Djeeberjr/fw-anwesenheit/README.md

# fw-anwesenheit

PXL_20251004_141110955 MP (1)

PXL_20251001_103957322 MP~2
