Djeeberjr/fw-anwesenheit/3d_print/enclouseure_printfile.3mf

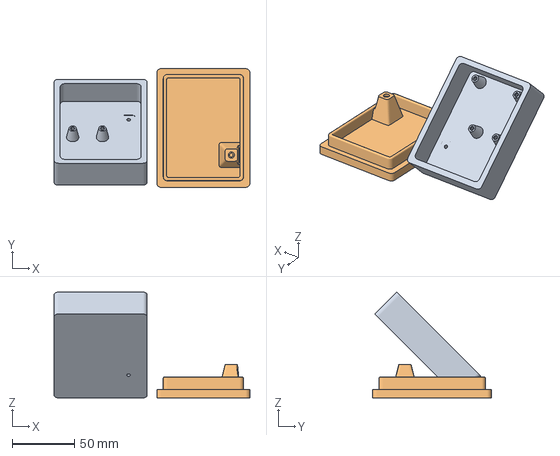
[picture p1: CAD file, 2025-09-21]
3d_print/enclouseure_printfile.3mf
157.7 x 95.5 x 85.2 mm
enclouseure_bot_ffw
enclousure_top_ffw
