Djeeberjr/fw-anwesenheit/3d_print/printfiles/fw-anwesenheit-enclousure-top.3mf

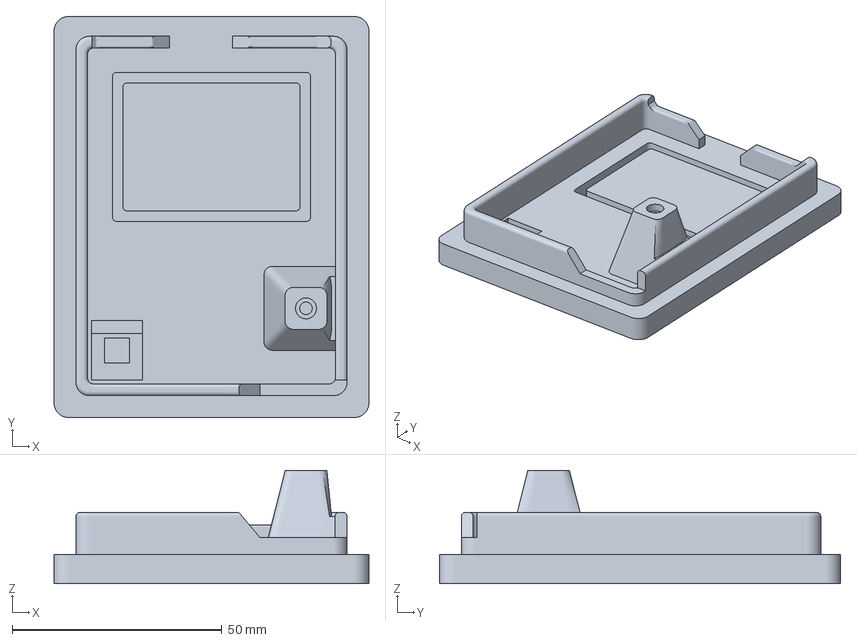
[picture p2: CAD file, 2025-10-01]
3d_print/printfiles/fw-anwesenheit-enclousure-top.3mf
75.0 x 95.5 x 27.0 mm
