Djeeberjr/fw-anwesenheit/3d_print/enclousure_top_ffw.3mf

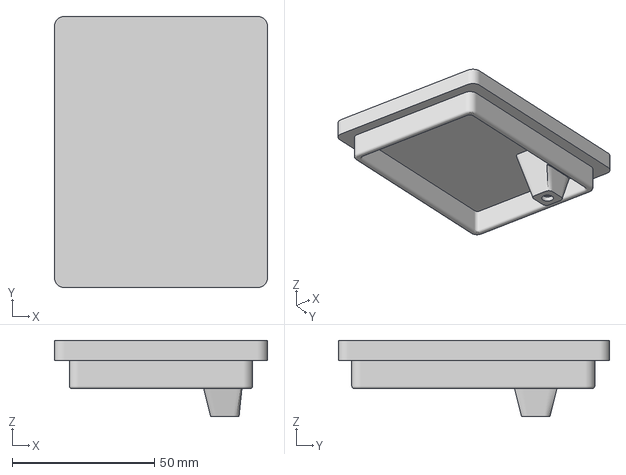
[picture p3: CAD file, 2025-09-21]
3d_print/enclousure_top_ffw.3mf
75.0 x 95.5 x 26.8 mm
