Djeeberjr/fw-anwesenheit/pcb/fw-anwesenheit.kicad_pcb

## KiCad design pcb/fw-anwesenheit.kicad_pcb (2025-09-21)

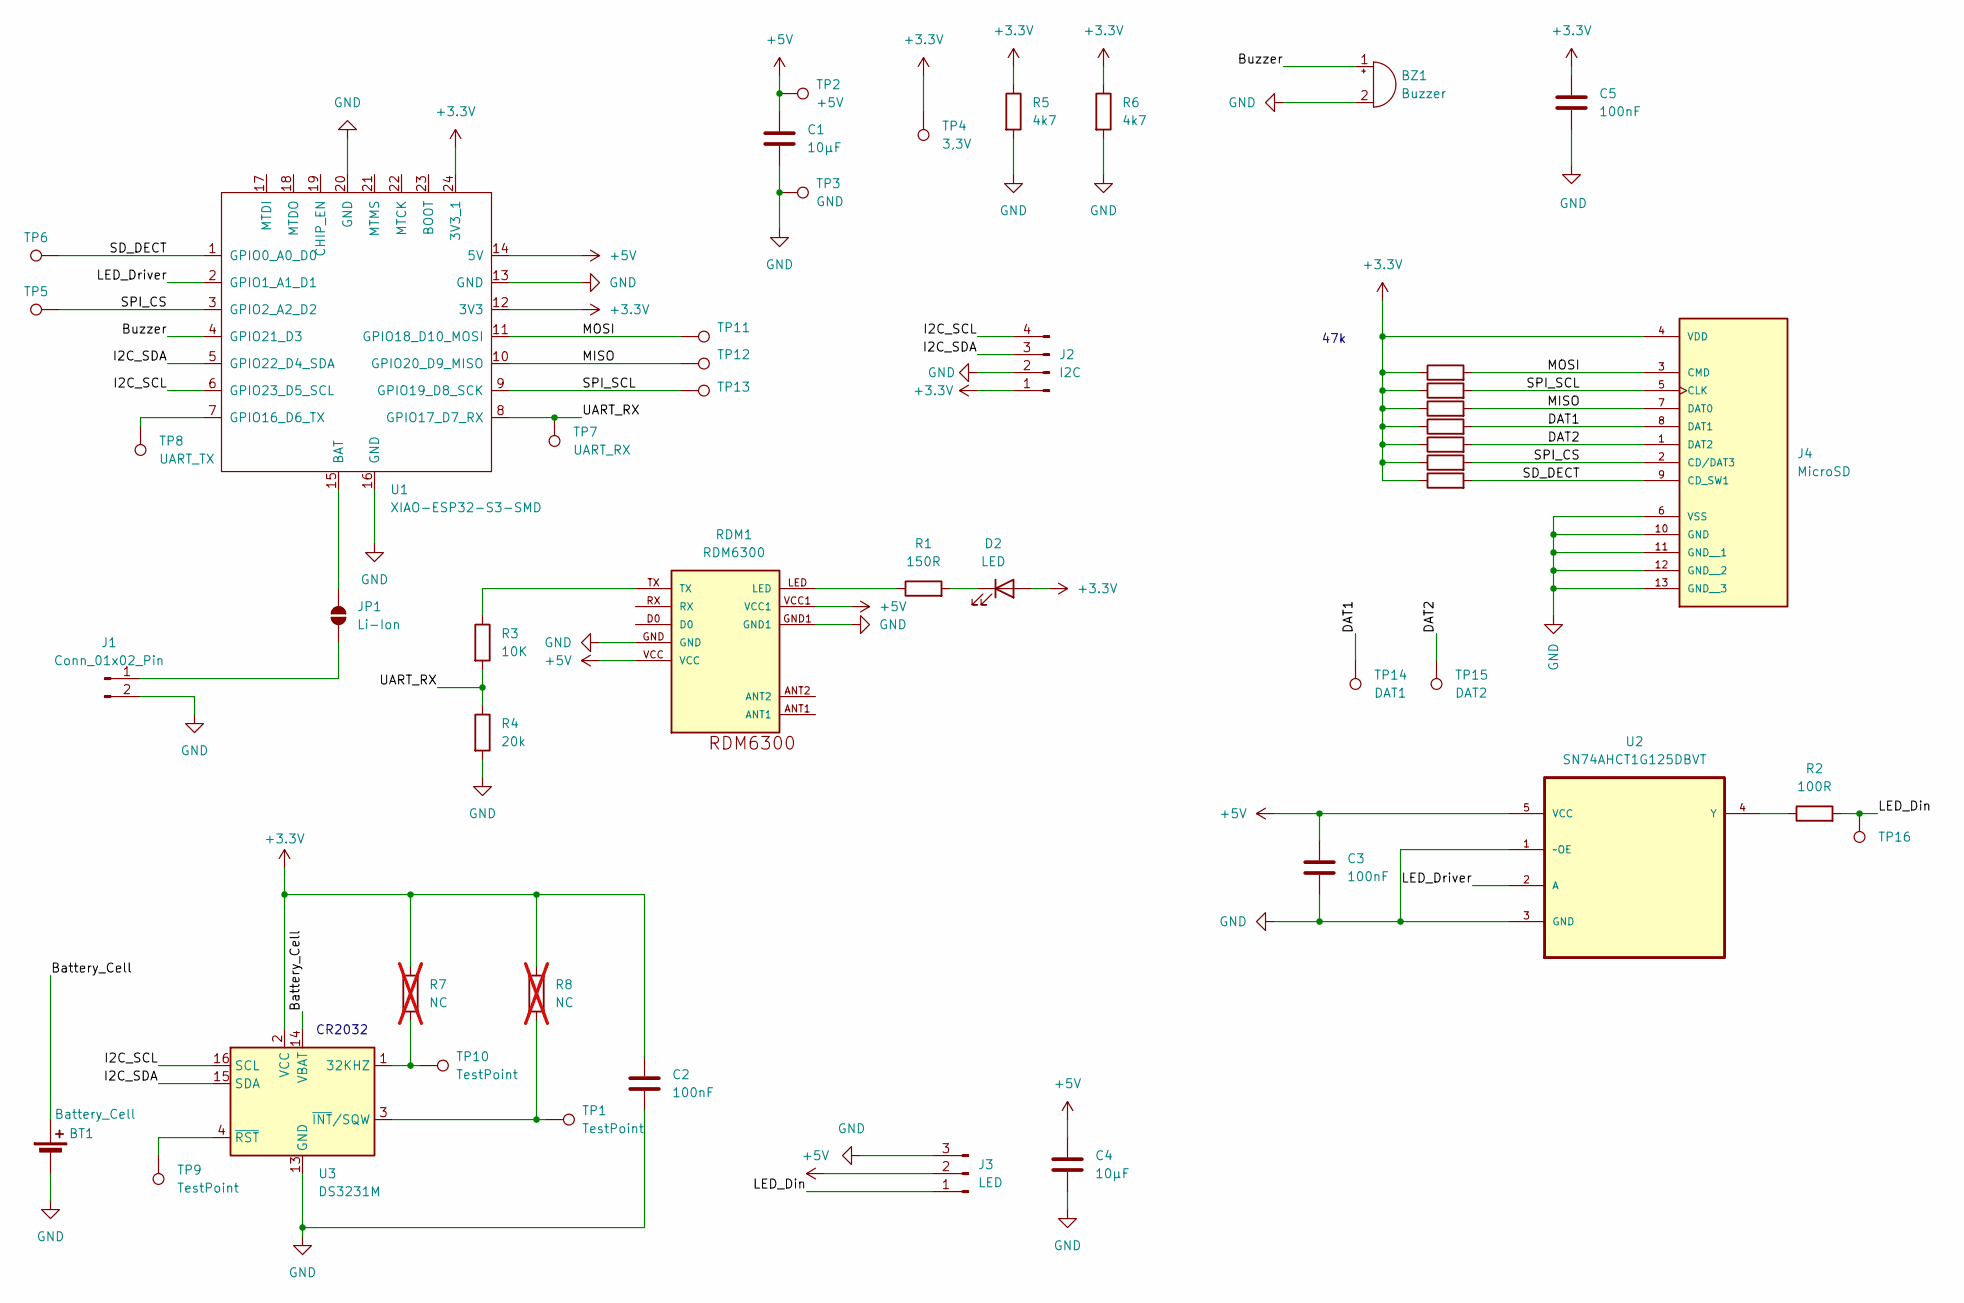
[picture p4: schematic fw-anwesenheit.kicad_sch]

Parts:
BT1: Battery_Cell; Battery_Panasonic_CR2032-HFN_Horizontal_CircularHoles
BZ1: Buzzer; PinSocket_1x02_P2.54mm_Vertical
C1, C4: 10µF; C_0603_1608Metric
C2, C3, C5: 100nF; C_0603_1608Metric
D2: LED; LED_0603_1608Metric
J1: Conn_01x02_Pin; PinHeader_1x02_P2.54mm_Vertical
J2: I2C; PinHeader_1x04_P2.54mm_Vertical
J3: LED; PinSocket_1x03_P2.00mm_Vertical
J4: MicroSD; WURTH_693071020811; PARTREV 001.003
JP1: Li-Ion; SolderJumper-2_P1.3mm_Open_TrianglePad1.0x1.5mm
R1: 150R; R_0603_1608Metric_Pad0.98x0.95mm_HandSolder
R2: 100R; R_0603_1608Metric_Pad0.98x0.95mm_HandSolder
R3: 10K; R_0603_1608Metric_Pad0.98x0.95mm_HandSolder
R4: 20k; R_0603_1608Metric_Pad0.98x0.95mm_HandSolder
R5, R6: 4k7; R_0603_1608Metric_Pad0.98x0.95mm_HandSolder
R7, R8: NC; R_0603_1608Metric_Pad0.98x0.95mm_HandSolder; not fitted
R9, R10, R11, R12, R13, R14, R15: 47k; R_0603_1608Metric_Pad0.98x0.95mm_HandSolder
RDM1: RDM6300
TP1, TP9, TP10: TestPoint; TestPoint_Pad_D1.5mm
TP2: +5V; TestPoint_Pad_D1.5mm
TP3: GND; TestPoint_Pad_D1.5mm
TP4: 3,3V; TestPoint_Pad_D1.5mm
TP5: CS; TestPoint_Pad_D1.5mm
TP6: SD_DECT; TestPoint_Pad_D1.5mm
TP7: UART_RX; TestPoint_Pad_D1.5mm
TP8: UART_TX; TestPoint_Pad_D1.5mm
TP11: MOSI; TestPoint_Pad_D1.5mm
TP12: MISO; TestPoint_Pad_D1.5mm
TP13: SPI SCL; TestPoint_Pad_D1.5mm
TP14: DAT1; TestPoint_Pad_D1.5mm
TP15: DAT2; TestPoint_Pad_D1.5mm
TP16: LED_Din; TestPoint_Pad_D1.5mm
U1: XIAO-ESP32-S3-SMD; XIAO-ESP32C6-SMD
U2: SN74AHCT1G125DBVT; SOT95P280X145-5N; MPN SN74AHCT1G125DBVT
U3: DS3231M; SOIC-16W_7.5x10.3mm_P1.27mm

Connections:
+3.3V: C2.2, C5.2, D2.2 (A), J2.1, J4.4 (VDD), R5.1, R6.1, R7.1, R8.1, R9.1, R10.1, R11.1, R12.1, R13.1, R14.1, R15.1, TP4.1, U1.12 (3V3), U1.24 (3V3_1), U3.2 (VCC)
+5V: C1.2, C3.2, C4.2, J3.2, RDM1.VCC, RDM1.VCC1, TP2.1, U1.14 (5V), U2.5 (VCC)
/Battery_Cell: BT1.1 (+), U3.14 (VBAT)
/Buzzer: BZ1.1 (+), U1.4 (GPIO21_D3)
/DAT1: J4.8 (DAT1), R10.2, TP14.1
/DAT2: J4.1 (DAT2), R15.2, TP15.1
/I2C_SCL: J2.4, U1.6 (GPIO23_D5_SCL), U3.16 (SCL)
/I2C_SDA: J2.3, U1.5 (GPIO22_D4_SDA), U3.15 (SDA)
/LED_Driver: U1.2 (GPIO1_A1_D1), U2.2 (A)
/MISO: J4.7 (DAT0), R12.2, TP12.1, U1.10 (GPIO20_D9_MISO)
/MOSI: J4.3 (CMD), R14.2, TP11.1, U1.11 (GPIO18_D10_MOSI)
/SD_DECT: J4.9 (CD_SW1), R11.2, TP6.1, U1.1 (GPIO0_A0_D0)
/SPI_SCL: J4.5 (CLK), R13.2, TP13.1, U1.9 (GPIO19_D8_SCK)
/UART_RX: R3.2, R4.1, TP7.1, U1.8 (GPIO17_D7_RX)
GND: BT1.2 (-), BZ1.2 (-), C1.1, C2.1, C3.1, C4.1, C5.1, J1.2, J2.2, J3.3, J4.6 (VSS), J4.10 (GND), J4.11 (GND__1), J4.12 (GND__2), J4.13 (GND__3), R4.2, R5.2, R6.2, RDM1.GND, RDM1.GND1, TP3.1, U1.13 (GND), U1.16 (GND), U1.20 (GND), U2.1 (~OE), U2.3 (GND), U3.5 (GND), U3.6 (GND), U3.7 (GND), U3.8 (GND), U3.9 (GND), U3.10 (GND), U3.11 (GND), U3.12 (GND), U3.13 (GND)
unnamed: D2.1 (K), R1.2
unnamed: J1.1, JP1.2 (B)
unnamed: JP1.1 (A), U1.15 (BAT)
unnamed: R1.1, RDM1.LED
unnamed: R3.1, RDM1.TX
unnamed: TP8.1, U1.7 (GPIO16_D6_TX)
unnamed: R2.1, U2.4 (Y)
unnamed: R7.2, TP10.1, U3.1 (32KHZ)
unnamed: R8.2, TP1.1, U3.3 (~INT/SQW)
unnamed: TP9.1, U3.4 (~RST)

Notes on the sheet:
CR2032
47k

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
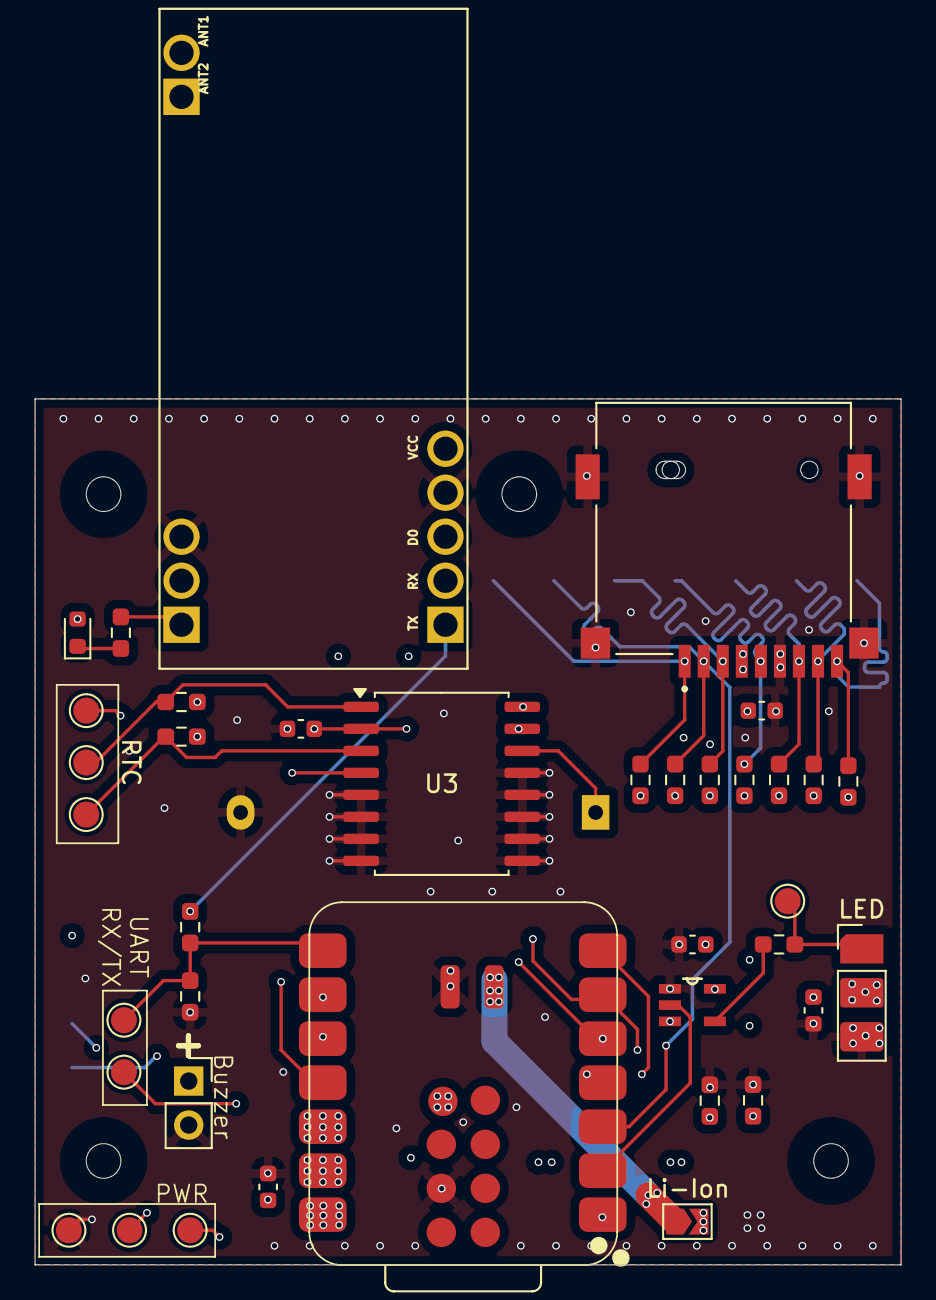
[picture p5: board fw-anwesenheit.kicad_pcb from above]

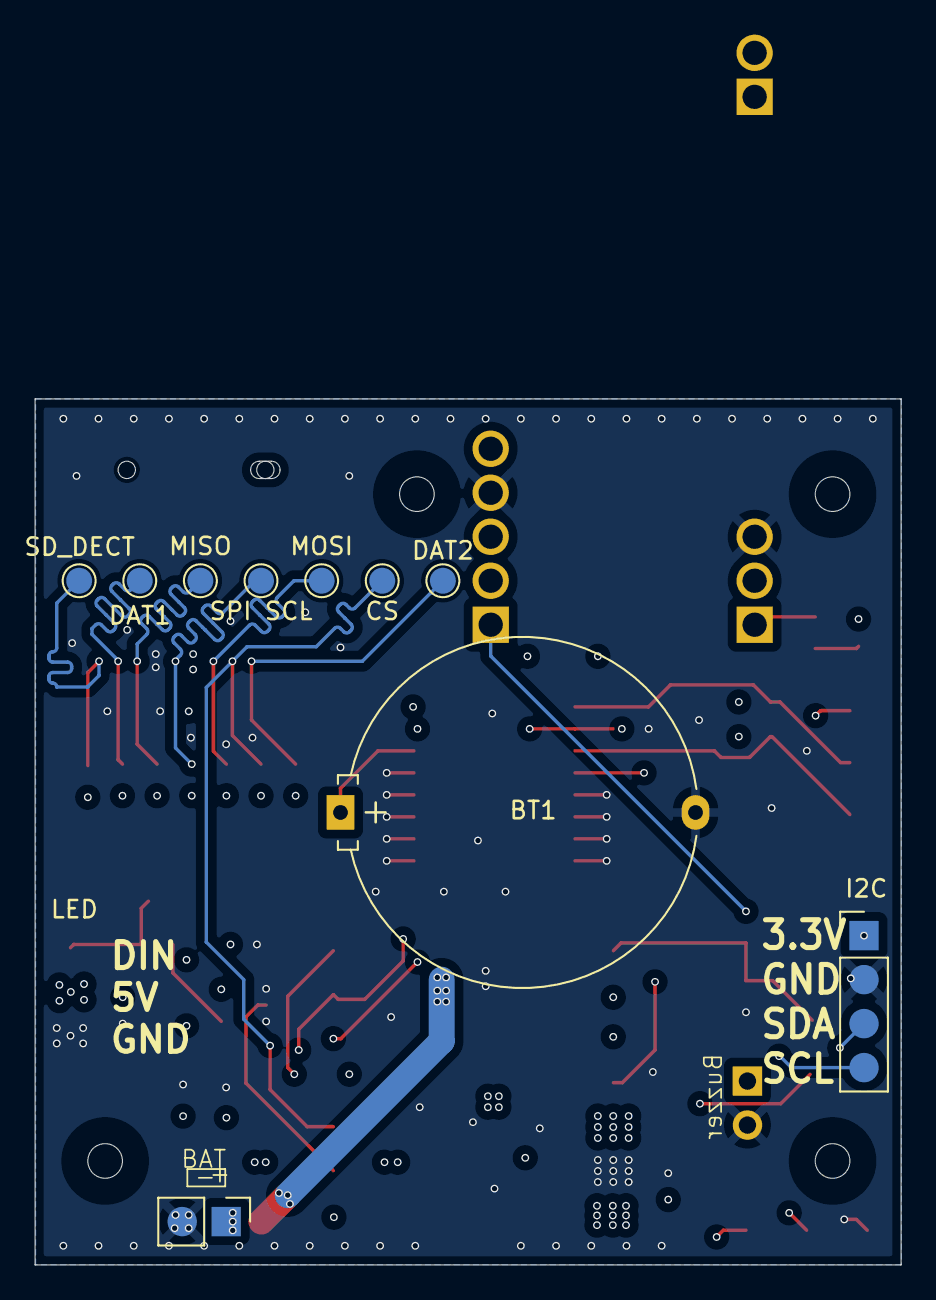
[picture p6: board fw-anwesenheit.kicad_pcb from below]

Board: 6 copper layers, 50.0 x 50.0 mm, 48 parts (10 on the bottom side), 27 nets.

Other parts of the board:
TP5#2: CS; TestPoint_Pad_D1.5mm
