Djeeberjr/fw-anwesenheit/src/bin/main.rs

#![no_std]
#![no_main]
#![feature(type_alias_impl_trait)]
#![feature(impl_trait_in_assoc_type)]

use embassy_executor::Spawner;
use embassy_net::Stack;
use embassy_sync::{
    blocking_mutex::raw::NoopRawMutex,
    pubsub::{
        PubSubChannel, Publisher,
        WaitResult::{Lagged, Message},
    },
};
use embassy_time::{Duration, Timer};
use esp_alloc::psram_allocator;
use esp_hal::Async;
use esp_hal::uart::Uart;
use log::{debug, info};
use static_cell::make_static;

use crate::{store::TallyID, webserver::start_webserver};

mod init;
mod store;
mod webserver;

type TallyChannel = PubSubChannel<NoopRawMutex, TallyID, 8, 2, 1>;
type TallyPublisher = Publisher<'static, NoopRawMutex, TallyID, 8, 2, 1>;

static mut UTC_TIME: u64 = 0;

#[esp_hal_embassy::main]
async fn main(mut spawner: Spawner) {
    let (uart_device, stack) = init::hardware_init(&mut spawner).await;

    wait_for_stack_up(stack).await;

    let chan: &'static mut TallyChannel = make_static!(PubSubChannel::new());

    start_webserver(&mut spawner, stack);

    let publisher = chan.publisher().unwrap();

    spawner.must_spawn(rfid_reader_task(uart_device, publisher));

    let mut sub = chan.subscriber().unwrap();
    loop {
        let wait_result = sub.next_message().await;
        match wait_result {
            Lagged(_) => debug!("Lagged"),
            Message(msg) => debug!("Got message: {msg:?}"),
        }
    }
}

async fn wait_for_stack_up(stack: Stack<'static>) {
    loop {
        if stack.is_link_up() {
            break;
        }
        Timer::after(Duration::from_millis(500)).await;
        if stack.is_config_up() {
            break;
        }
        Timer::after(Duration::from_millis(500)).await;
    }
}

#[embassy_executor::task]
async fn rfid_reader_task(mut uart_device: Uart<'static, Async>, chan: TallyPublisher) {
    let mut uart_buffer = [0u8; 64];

    loop {
        debug!("Looking for NFC...");
        match uart_device.read_async(&mut uart_buffer).await {
            Ok(n) => {
                let mut hex_str = heapless::String::<64>::new();
                for byte in &uart_buffer[..n] {
                    core::fmt::Write::write_fmt(&mut hex_str, format_args!("{:02X} ", byte)).ok();
                }
                info!("Read {n} bytes from UART: {hex_str}");
                chan.publish([1, 0, 2, 5, 0, 8, 12, 15]).await;
            }
            Err(e) => {
                log::error!("Error reading from UART: {e}");
            }
        }
        Timer::after(Duration::from_millis(200)).await;
    }
}
