Djeeberjr/fw-anwesenheit/(commit log)

2025-04-16 Switched to tokio and added webserver
2025-04-16 fixed git fuck up
    [main.rs, webserver.rs]
2025-04-16 added arm target in .toml fixed some shit
    [main.rs]
2025-04-16 added export_csv to id_store
    Also some fixes and formatting
    [id_store.rs]
2025-04-22 download csv button now works
2025-04-27 minor improvements in pm3.rs
    - use trace instead of debug
    - use a loop instead of while true
    - ? operator on child.wait()
2025-05-05 added led ws 2812 and buzzer stuff
    [buzzer.rs, id_store.rs, led.rs, main.rs]
2025-05-05 fixed buzzer use in tokio thread
    [buzzer.rs, id_store.rs, main.rs]
2025-05-05 fixed some buzzer timings
    [buzzer.rs, main.rs]
2025-05-08 Update README.md
    added instruction to enable PWM
2025-05-08 rewrited buzzer for 2,5kHz Buzzer and use PWM icreased SPI frequency to 3.8MHz
    [buzzer.rs, led.rs, main.rs]
2025-05-12 fixed timings for LED
    [led.rs]
2025-05-12 added TODO and status LED
2025-05-12 moved TallyID into it's own file
    Tally id now ignores tha case since it's basicly a hex value as a
    string. Reason for that is that if a user inputs an id.
2025-05-12 improved error handling in buzzer and led
    [buzzer.rs, led.rs]
2025-05-12 refactored led & buzzer feedback in main
    [main.rs]
2025-05-13 implemented mocking of rpi hardware
    buzzer,led & hotspot got traits and a mock version of it. Based on the
    flag the real or mock version is used.
    [buzzer.rs, led.rs, main.rs]
2025-05-16 switched to svelte 5
    front gets a bit to complex to do in vanilla
2025-05-20 added 3d print files
    [Deckel.3mf, Gehause.3mf, LWL.3mf, Proxmark_halter.3mf]
2025-05-20 prevent adding empty id mapping
    [webserver.rs]
2025-05-20 inserted AddIDModal
2025-05-20 moved 3d_print directory
    [Deckel.3mf, Gehause.3mf, LWL.3mf, Proxmark_halter.3mf]
2025-06-01 refactored feedback & its depending stuff
    - buzzer is just modulate_tone
    - led is just turn on and off
    - handle feedback logic to feeback file
    [buzzer.rs, feedback.rs, led.rs, main.rs]
2025-06-02 use anyhow for errors
    [feedback.rs, hardware.rs, id_store.rs, main.rs]
2025-06-05 added error state flag
    [feedback.rs, main.rs]
2025-06-17 added passive status led + startup sound
2025-07-24 init v2
    [Deckel.3mf, Gehause.3mf, LWL.3mf, Proxmark_halter.3mf]
2025-07-26 added i2c init
2025-07-28 redesigned dir structure for rust 2018 style guide. made (untested) rtc funtion
    [feedback.rs, hardware.rs, id_store.rs, main.rs, mod.rs, network.rs]
2025-07-30 added buzzer and rtc. rtc freeze the system, bevore interrupt can be initilized..
    [build.rs, buzzer.rs, feedback.rs, hardware.rs, main.rs, rtc.rs]
2025-08-01 buzzer without pwm, and feedback with embassy Sync. Error when more then 4 tasks spawn
    [buzzer.rs, feedback.rs, hardware.rs, main.rs, nfc_reader.rs, rtc.rs]
2025-08-04 reworked RTC without alarms and without own thread
    [hardware.rs, main.rs, rtc.rs]
2025-08-04 fixed embassy taks arena size
    [hardware.rs]
2025-08-11 chanched GPIO Pin configuration
2025-08-12 try to control LED with SmartLED and RMT
2025-08-12 test LED Array works..
2025-08-13 LED is working and implement in feedback
2025-08-13 still some errors with LED an levelshifter...
    [hardware.rs]
2025-08-15 circuit diagram is finish v1
    [fw-anwesenheit.kicad_pcb, fw-anwesenheit.kicad_sch]
2025-08-15 pcb v1 finish
    [fw-anwesenheit-B_Cu.gbl, fw-anwesenheit-B_Mask.gbs, fw-anwesenheit-B_Paste.gbp, fw-anwesenheit-B_Silkscreen.gbo, fw-anwesenheit-Edge_Cuts.gm1, fw-anwesenheit-F_Cu.gtl, fw-anwesenheit-F_Mask.gts, fw-anwesenheit-F_Paste.gtp]
2025-08-23 fixed RTC footprint and some labels
    [fw-anwesenheit-B_Cu.gbl, fw-anwesenheit-B_Mask.gbs, fw-anwesenheit-B_Paste.gbp, fw-anwesenheit-B_Silkscreen.gbo, fw-anwesenheit-Edge_Cuts.gm1, fw-anwesenheit-F_Cu.gtl, fw-anwesenheit-F_Mask.gts, fw-anwesenheit-F_Paste.gtp]
2025-09-01 updated pcb
    [bom.csv, designators.csv, fw-anwesenheit.kicad_sch, positions.csv]
2025-09-01 changed via size
    [bom.csv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]
2025-09-09 there are some problems to implemet the IO Mux interrupt handler
    [feedback.rs, hardware.rs]
2025-09-21 changed some pcb descriptions and Resistor for LED
    [enclouseure_printfile.3mf, enclousure_top_ffw.3mf, fw-anwesenheit.kicad_pcb, fw-anwesenheit.kicad_sch]
2025-09-21 fixed buzzer footprint
    [bom.csv, fw-anwesenheit.kicad_pcb, fw-anwesenheit.kicad_sch, positions.csv]
2025-09-21 deleted KiCAD backup files
2025-09-21 added some descriptions on pcb layout
    [fw-anwesenheit.kicad_pcb]
2025-09-30 added kicad backups to gitignore
2025-10-01 updated enclousure top 3mf
    [fw-anwesenheit-enclousure-top.3mf]
2025-10-07 pined picoserve to current git version
2025-10-07 fixed webserver not working
    - shared store in main
    - multiple tasks for webserver
    [main.rs, mod.rs]
2025-10-07 fixed many warning by removing unused imports
    Removed a lot of imports — believe me, so many imports were totally
    unnecessary. Nobody’s seen imports like these. Cleaned up the code, made
    it faster, smarter, the best code. People are talking about it!
    Tremendous work by me. Some say i am the best at it. It may be true.
    [feedback.rs, hardware.rs, id_store.rs, main.rs, mod.rs, network.rs, nfc_reader.rs]
2025-10-08 fixed RFID read id parser
    [nfc_reader.rs]
2025-10-09 implemented missing load & save mapping functions
    [sd_card.rs]
2025-10-11 fixed list_day for sd_card
    [sd_card.rs]
2025-10-11 fixed RFID reader outputting un-aligned IDs in buffer
    [nfc_reader.rs]
2025-10-15 Revert "updated panic handler"
    This reverts commit c4d6ed45f1f57e92be21142b81a1fd2b52a5924f.
    [hardware.rs]
2025-10-20 added software resett after 10min when panic
    [hardware.rs]
2025-10-23 added missing persist mapping
    [id_store.rs]
2025-10-25 feedback ack turns LED off after lighting green
2025-10-27 changed LED amount to 1
2025-10-27 moved LED and feedback to new lib
2025-10-27 pass current day to IDStore constructor
2025-10-27 added red led flash in inti to see a failer on init routine
    [hardware.rs]
2025-11-03 improved error handeling for sdcard functions
    [id_store.rs, main.rs, sd_card.rs]
2026-09-02 added function to the time sync button
2026-09-10 implmented delete days button
    & shared css for buttons
2026-09-10 added in-browser console for debugging on device
2026-09-21 display green led (SilentAck) on successfull RFID read
    normal ACK when added to day
